UVicRocketry/A3_Modular_Power_Supply/A3_Modular_Power_Supply/3D_models/PSMC_TO-277A__STM.step

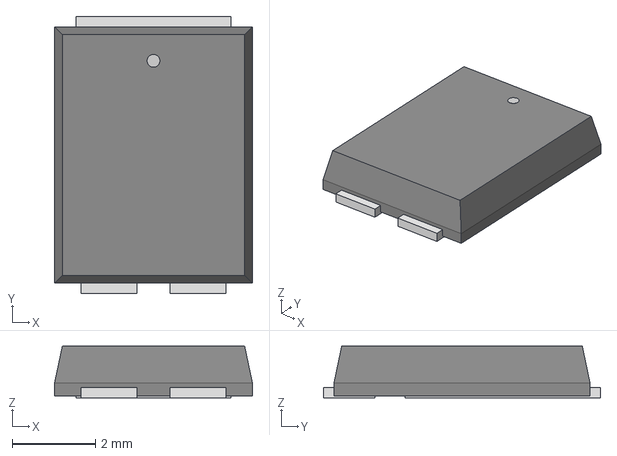
[picture p1: CAD file, 2026-06-01, an earlier design]
A3_Modular_Power_Supply/3D_models/PSMC_TO-277A__STM.step
4.75 x 6.65 x 1.25 mm
