UVicRocketry/A3_Modular_Power_Supply/A3_Modular_Power_Supply/3D_models/FX30B-3P-7.62DSA20.stp

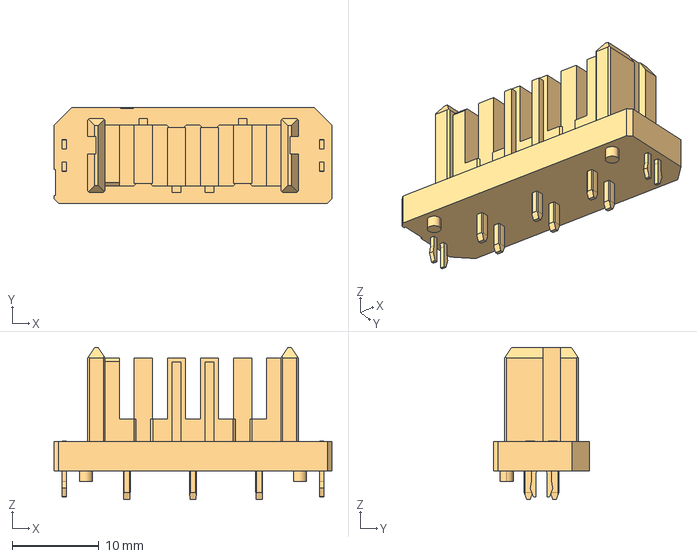
[picture p2: CAD file, 2025-11-07, an earlier design]
A3_Modular_Power_Supply/3D_models/FX30B-3P-7.62DSA20.stp
32.0 x 11.0 x 17.5 mm
