UVicRocketry/A3_Modular_Power_Supply/A3_Modular_Power_Supply/3D_models/FX30B-3S-7.62DSA.stp

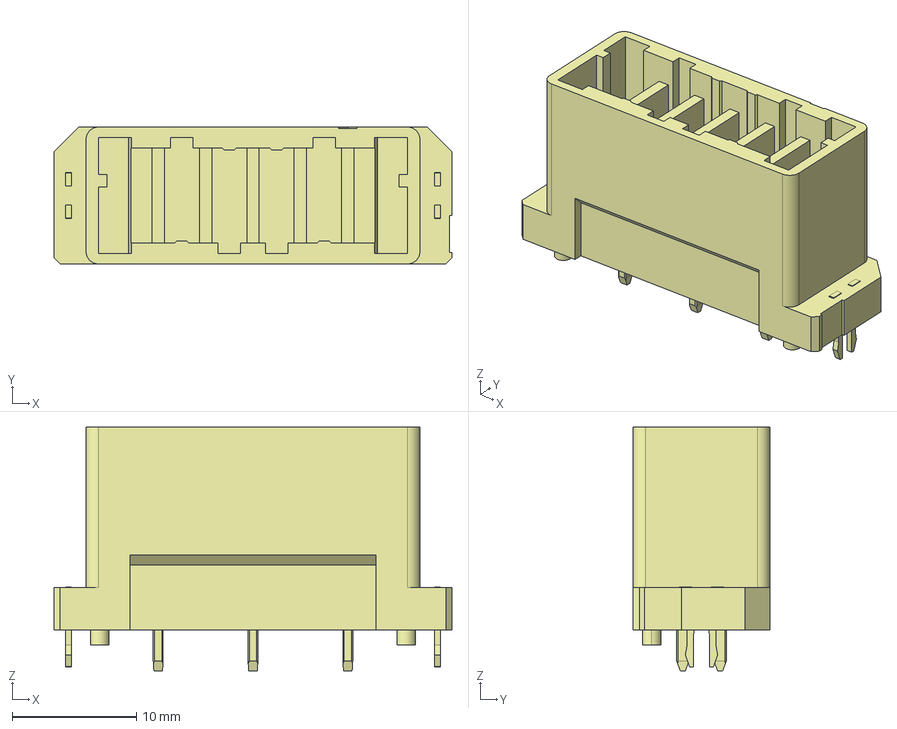
[picture p3: CAD file, 2025-11-07, an earlier design]
A3_Modular_Power_Supply/3D_models/FX30B-3S-7.62DSA.stp
32.0 x 11.0 x 19.6 mm
