UVicRocketry/A3_Modular_Power_Supply/A3_Modular_Power_Supply/3D_models/B2PS-VH.step

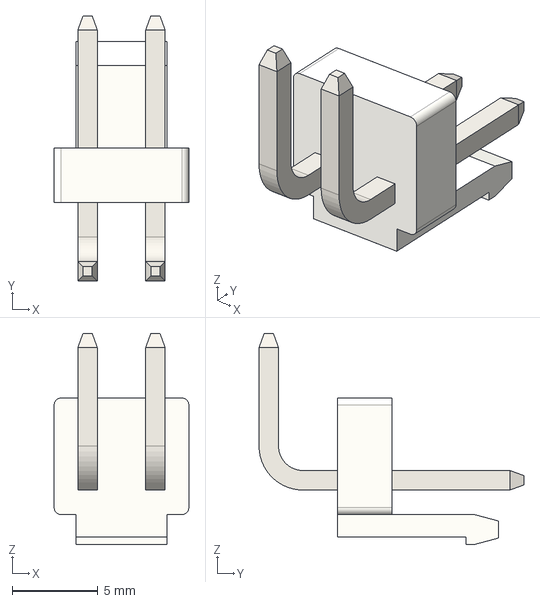
[picture p4: CAD file, 2025-11-07, an earlier design]
A3_Modular_Power_Supply/3D_models/B2PS-VH.step
7.86 x 15.5 x 12.3 mm
