UVicRocketry/A3_Modular_Power_Supply/A3_Modular_Power_Supply/3D_models/MAXIM_90-100154.step

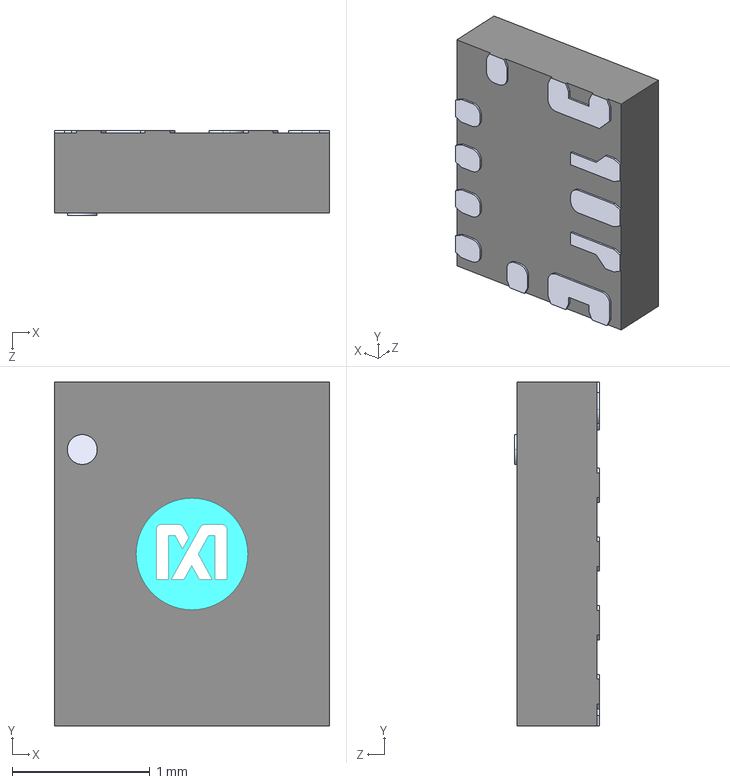
[picture p5: CAD file, 2025-11-07, an earlier design]
A3_Modular_Power_Supply/3D_models/MAXIM_90-100154.step
2.00 x 2.50 x 0.62 mm
