UVicRocketry/A3_Modular_Power_Supply/A3_Modular_Power_Supply/3D_models/SRP1265A series.stp

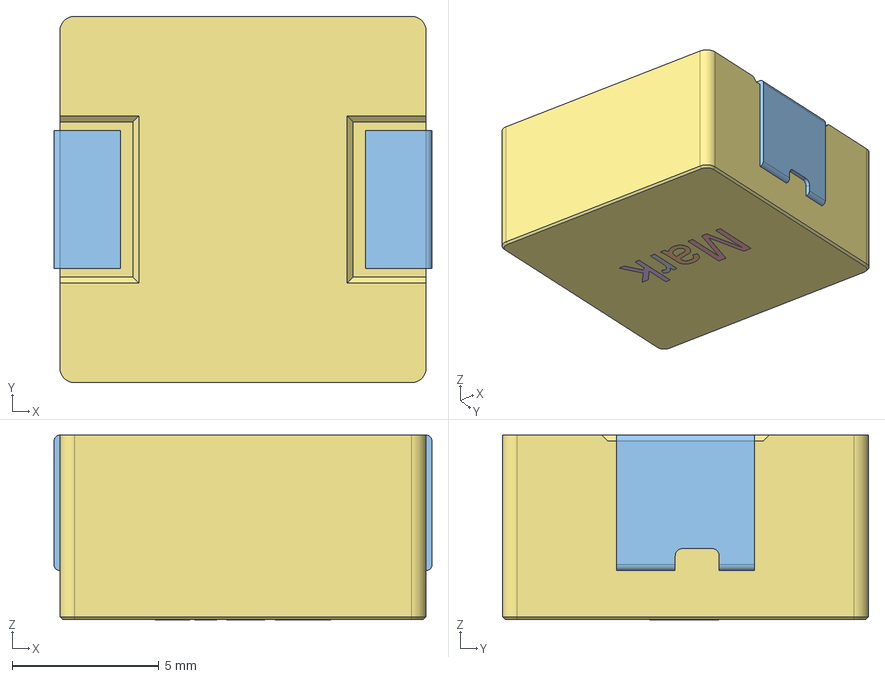
[picture p6: CAD file, 2025-11-07, an earlier design]
A3_Modular_Power_Supply/3D_models/SRP1265A series.stp
12.9 x 12.5 x 6.30 mm
