UVicRocketry/A3_Modular_Power_Supply/A3_Modular_Power_Supply/3D_models/STP_74438366xxx+%28rev1%29.stp

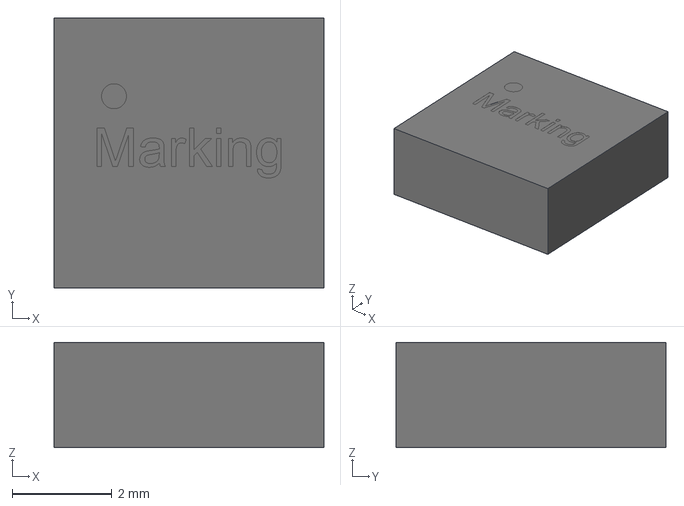
[picture p7: CAD file, 2025-11-07, an earlier design]
A3_Modular_Power_Supply/3D_models/STP_74438366xxx+%28rev1%29.stp
5.40 x 5.40 x 2.10 mm
body_SSMC_5020
land_pattern x 2
