UVicRocketry/A3_Modular_Power_Supply/A3_Modular_Power_Supply/3D_models/74439346xxx (rev1).stp

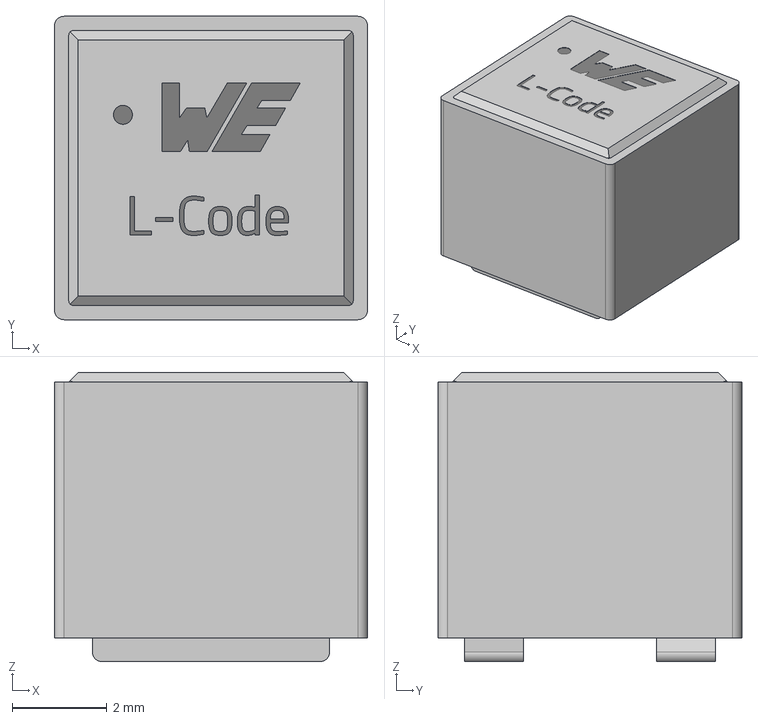
[picture p8: CAD file, 2026-06-01, an earlier design]
A3_Modular_Power_Supply/3D_models/74439346xxx (rev1).stp
6.60 x 6.40 x 6.10 mm
