UVicRocketry/A3_Modular_Power_Supply/A3_Modular_Power_Supply_v2/A3_Modular_Power_Supply_v2.kicad_pcb

## KiCad design A3_Modular_Power_Supply_v2/A3_Modular_Power_Supply_v2.kicad_pcb (2026-06-02)

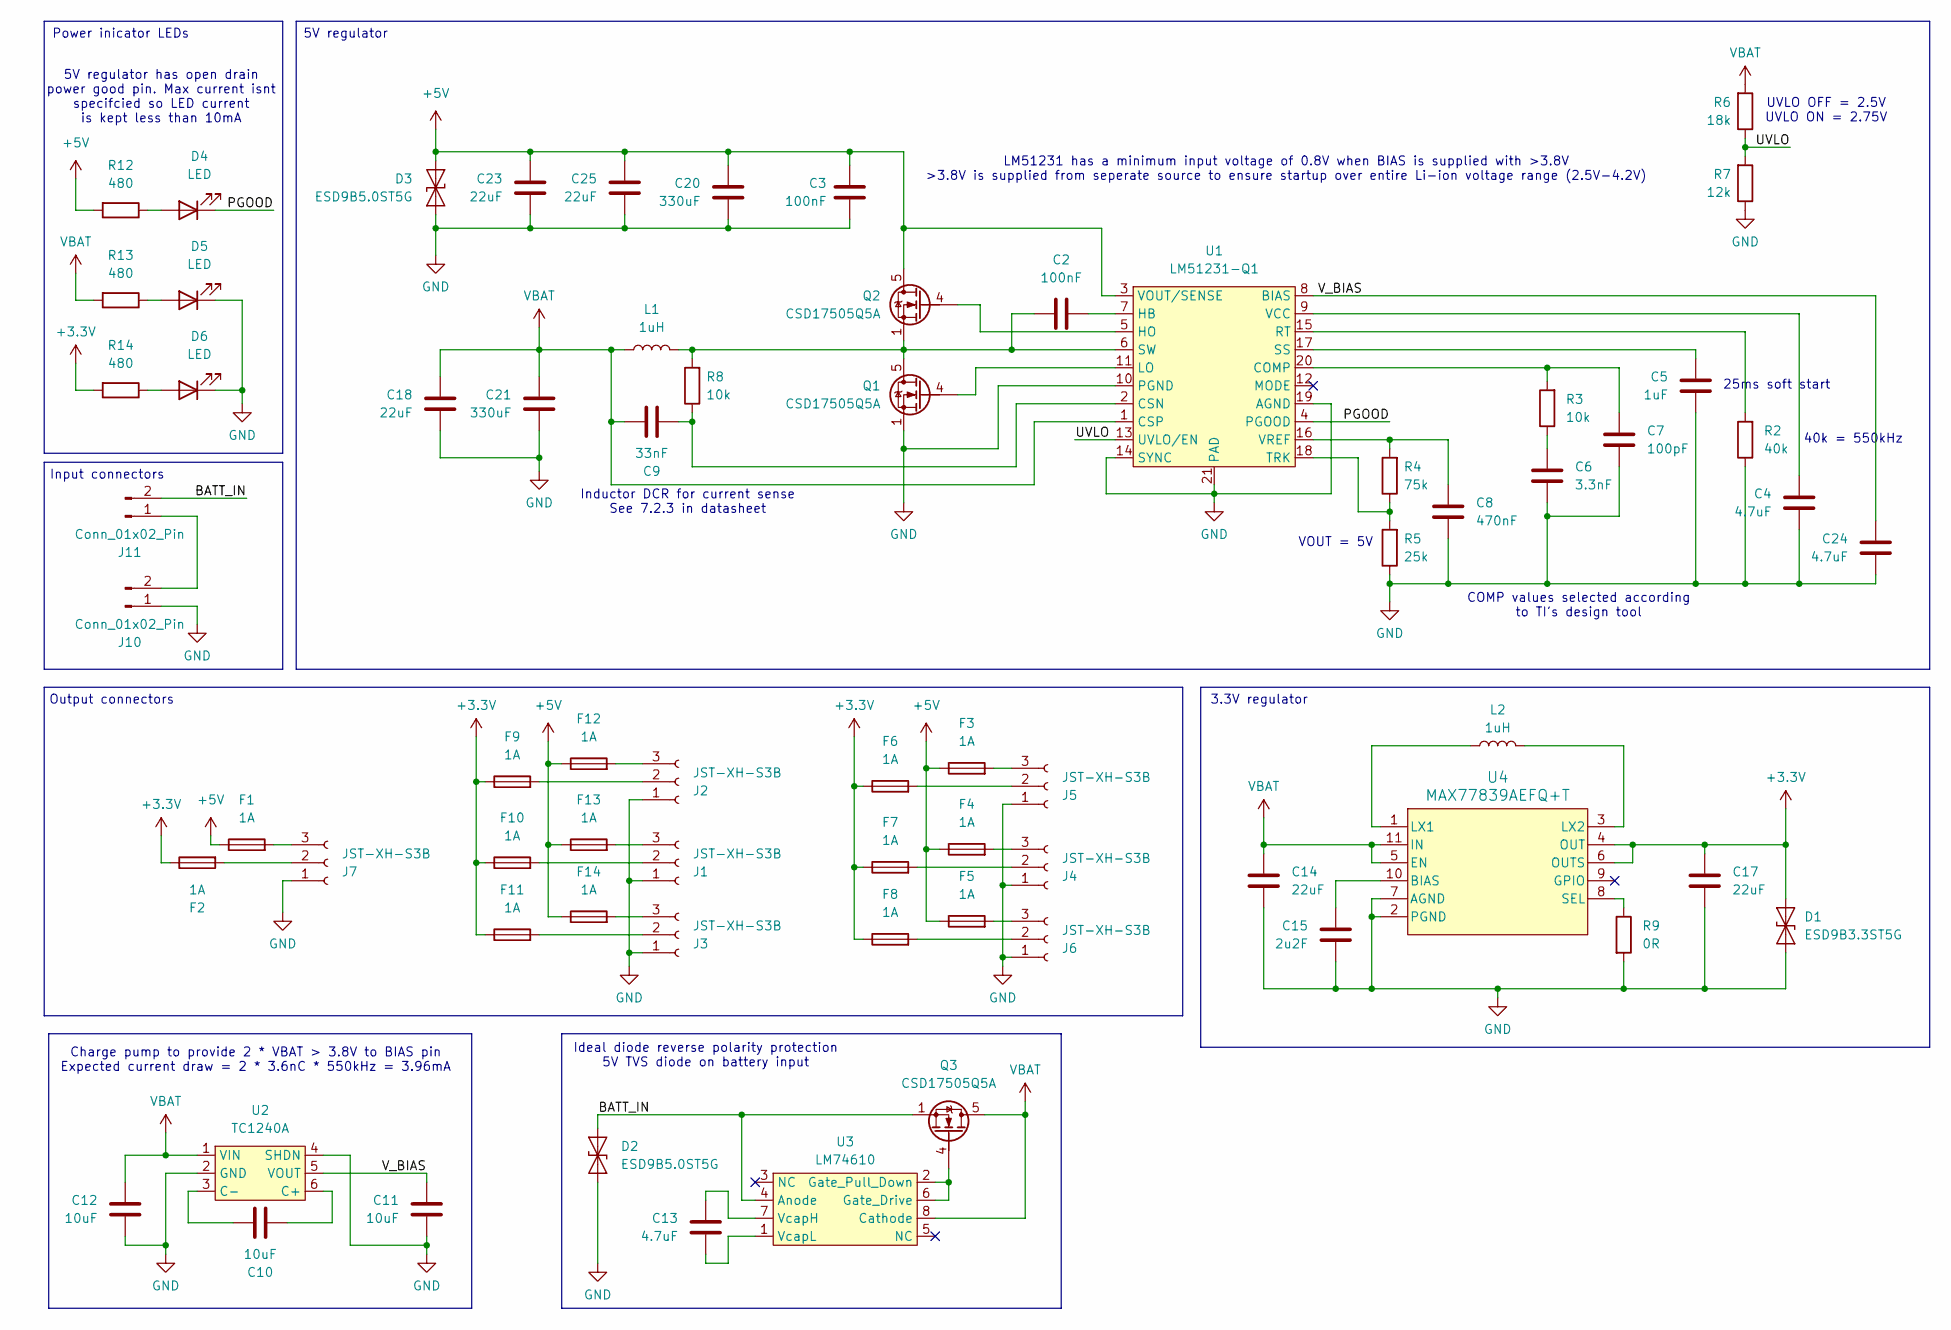
[picture p9: schematic A3_Modular_Power_Supply_v2.kicad_sch]

Parts:
C2, C3: 100nF; C_0402_1005Metric
C4, C13, C24: 4.7uF; C_0603_1608Metric
C5: 1uF; C_0402_1005Metric
C6: 3.3nF; C_0402_1005Metric
C7: 100pF; C_0402_1005Metric
C8: 470nF; C_0402_1005Metric
C9: 33nF; C_0402_1005Metric
C10, C11, C12: 10uF; C_0603_1608Metric
C14, C17, C18, C23, C25: 22uF; C_1210_3225Metric
C15: 2u2F; C_0603_1608Metric
C20, C21: 330uF; CP_Elec_6.3x7.7
D1: ESD9B3.3ST5G; D_SOD-923
D2, D3: ESD9B5.0ST5G; D_SOD-923
D4, D5, D6: LED; LED_0603_1608Metric
F1, F2, F3, F4, F5, F6, F7, F8, F9, F10, F11, F12, F13, F14: 1A; Fuse_0603_1608Metric
J1, J2, J3, J4, J5, J6, J7: JST-XH-S3B; JST_XH_S3B-XH-A_1x03_P2.50mm_Horizontal
J10, J11: Conn_01x02_Pin; JST_VH_B2PS-VH_1x02_P3.96mm_Horizontal
L1: 1uH; SRP1038WA
L2: 1uH; L_Wuerth_MAPI-5020
Q1, Q2, Q3: CSD17505Q5A; TDSON-8-1
R2: 40k; R_0402_1005Metric
R3, R8: 10k; R_0402_1005Metric
R4: 75k; R_0402_1005Metric
R5: 25k; R_0402_1005Metric
R6: 18k; R_0402_1005Metric
R7: 12k; R_0402_1005Metric
R9: 0R; R_0402_1005Metric
R12, R13, R14: 480; R_0402_1005Metric
U1: LM51231-Q1; QFN-20-1EP_3.5x3.5mm_P0.5mm_EP2x2mm
U2: TC1240A; TSOT-23-6
U3: LM74610; VSSOP-8_3x3mm_P0.65mm
U4: MAX77839AEFQ+T; 21-100431_F112A2F&plus_1_MXM

Connections:
+3.3V: C17.1, D1.2 (A2), F2.1, F6.1, F7.1, F8.1, F9.1, F10.1, F11.1, R14.2, U4.4 (OUT), U4.6 (OUTS)
+5V: C3.2, C20.1, C23.1, C25.1, D3.2 (A2), F1.1, F3.1, F4.1, F5.1, F12.1, F13.1, F14.1, Q2.5 (D), R12.2, U1.3 (VOUT/SENSE)
/BATT_IN: D2.2 (A2), J11.2, Q3.1 (S), Q3.2 (S), Q3.3 (S), U3.4 (Anode)
/PGOOD: D4.1 (K), U1.4 (PGOOD)
/UVLO: R6.1, R7.2, U1.13 (UVLO/EN)
/V_BIAS: C11.1, C24.1, U1.8 (BIAS), U2.5 (VOUT)
GND: C3.1, C4.2, C5.2, C6.2, C7.2, C8.2, C11.2, C12.2, C14.2, C15.2, C17.2, C18.2, C20.2, C21.2, C23.2, C24.2, C25.2, D1.1 (A1), D2.1 (A1), D3.1 (A1), D5.1 (K), D6.1 (K), J1.1, J2.1, J3.1, J4.1, J5.1, J6.1, J7.1, J10.1, Q1.1 (S), Q1.2 (S), Q1.3 (S), R2.1, R5.1, R7.1, R9.2, U1.10 (PGND), U1.14 (SYNC), U1.19 (AGND), U1.21 (PAD), U2.2 (GND), U2.4 (SHDN), U4.2 (PGND), U4.7 (AGND)
unnamed: C6.1, R3.1
unnamed: D4.2 (A), R12.1
unnamed: D5.2 (A), R13.1
unnamed: D6.2 (A), R14.1
unnamed: F10.2, J1.2
unnamed: F13.2, J1.3
unnamed: F9.2, J2.2
unnamed: F12.2, J2.3
unnamed: F11.2, J3.2
unnamed: F14.2, J3.3
unnamed: F7.2, J4.2
unnamed: F4.2, J4.3
unnamed: F6.2, J5.2
unnamed: F3.2, J5.3
unnamed: F8.2, J6.2
unnamed: F5.2, J6.3
unnamed: F2.2, J7.2
unnamed: F1.2, J7.3
unnamed: J10.2, J11.1
unnamed: C2.1, L1.2, Q1.5 (D), Q2.1 (S), Q2.2 (S), Q2.3 (S), R8.2, U1.6 (SW)
unnamed: Q1.4 (G), U1.11 (LO)
unnamed: Q2.4 (G), U1.5 (HO)
unnamed: Q3.4 (G), U3.2 (Gate_Pull_Down), U3.6 (Gate_Drive)
unnamed: C7.1, R3.2, U1.20 (COMP)
unnamed: C9.1, R8.1, U1.2 (CSN)
unnamed: C2.2, U1.7 (HB)
unnamed: R2.2, U1.15 (RT)
unnamed: C5.1, U1.17 (SS)
unnamed: R4.1, R5.2, U1.18 (TRK)
unnamed: C4.1, U1.9 (VCC)
unnamed: C8.1, R4.2, U1.16 (VREF)
unnamed: C10.1, U2.6 (C+)
unnamed: C10.2, U2.3 (C-)
unnamed: C13.1, U3.7 (VcapH)
unnamed: C13.2, U3.1 (VcapL)
unnamed: C15.1, U4.10 (BIAS)
unnamed: L2.1, U4.1 (LX1)
unnamed: L2.2, U4.3 (LX2)
unnamed: R9.1, U4.8 (SEL)
VBAT: C9.2, C12.1, C14.1, C18.1, C21.1, L1.1, Q3.5 (D), R6.2, R13.2, U1.1 (CSP), U2.1 (VIN), U3.8 (Cathode), U4.5 (EN), U4.11 (IN)

Notes on the sheet:
5V regulator has open drain power good pin. Max current isnt specifcied so LED current is kept less than 10mA
VOUT = 5V
COMP values selected according to TI's design tool
Inductor DCR for current sense See 7.2.3 in datasheet
Charge pump to provide 2 * VBAT > 3.8V to BIAS pin Expected current draw = 2 * 3.6nC * 550kHz = 3.96mA
Input connectors
Power inicator LEDs
LM51231 has a minimum input voltage of 0.8V when BIAS is supplied with >3.8V >3.8V is supplied from seperate source to ensure startup over entire Li-ion voltage range (2.5V-4.2V)
Ideal diode reverse polarity protection 5V TVS diode on battery input
40k = 550kHz
UVLO OFF = 2.5V UVLO ON = 2.75V
25ms soft start
3.3V regulator
Output connectors
5V regulator

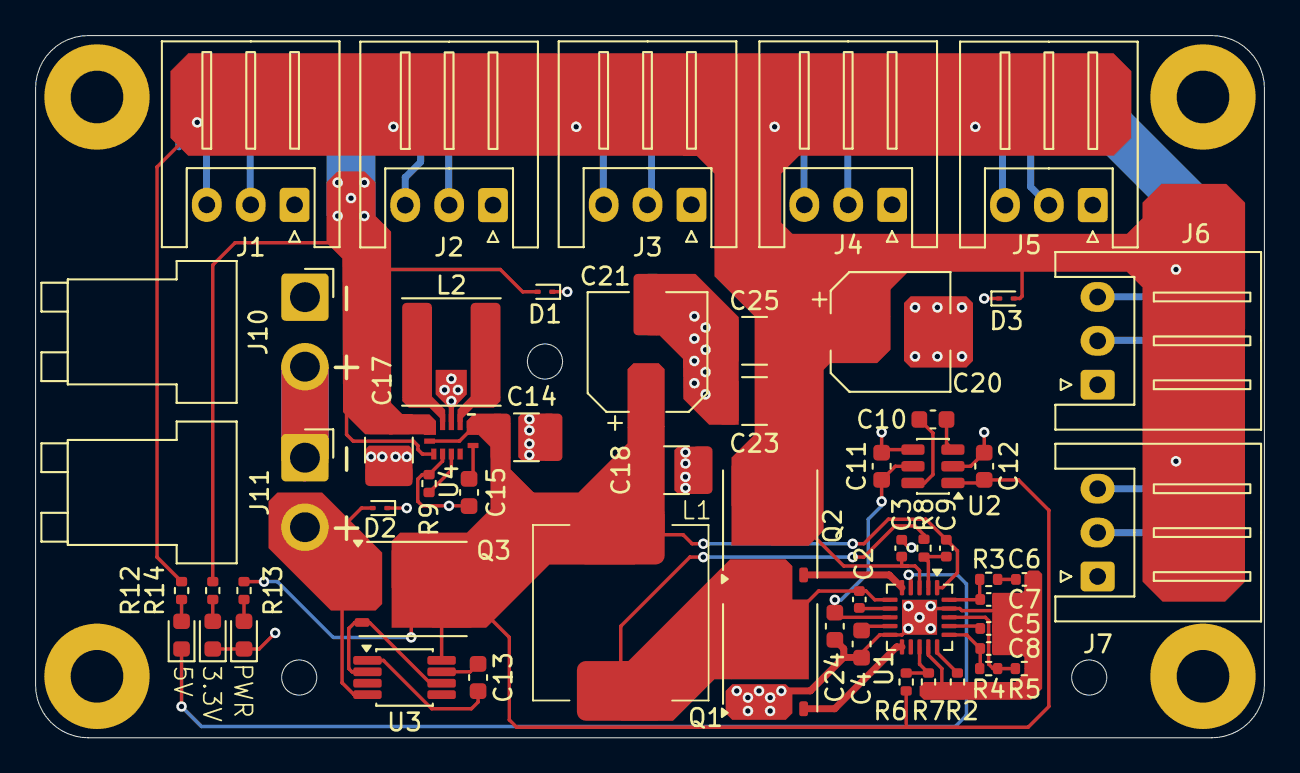
[picture p10: board A3_Modular_Power_Supply_v2.kicad_pcb from above]

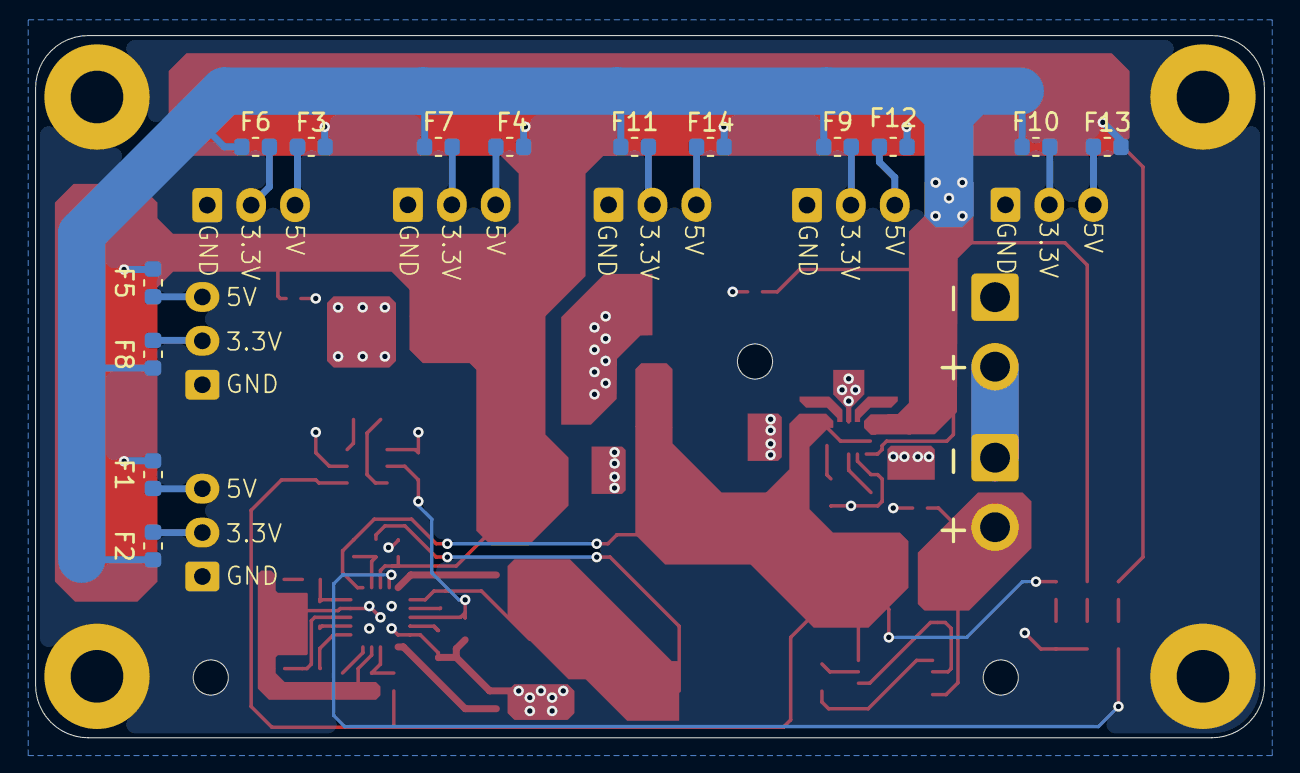
[picture p11: board A3_Modular_Power_Supply_v2.kicad_pcb from below]

Board: 2 copper layers, 70.0 x 40.0 mm, 70 parts (14 on the bottom side), 47 nets.
