UVicRocketry/A3_Modular_Power_Supply/A3_Modular_Power_Supply/A3_Modular_Power_Supply.kicad_pcb

## KiCad design A3_Modular_Power_Supply/A3_Modular_Power_Supply.kicad_pcb (2026-01-04, an earlier design)

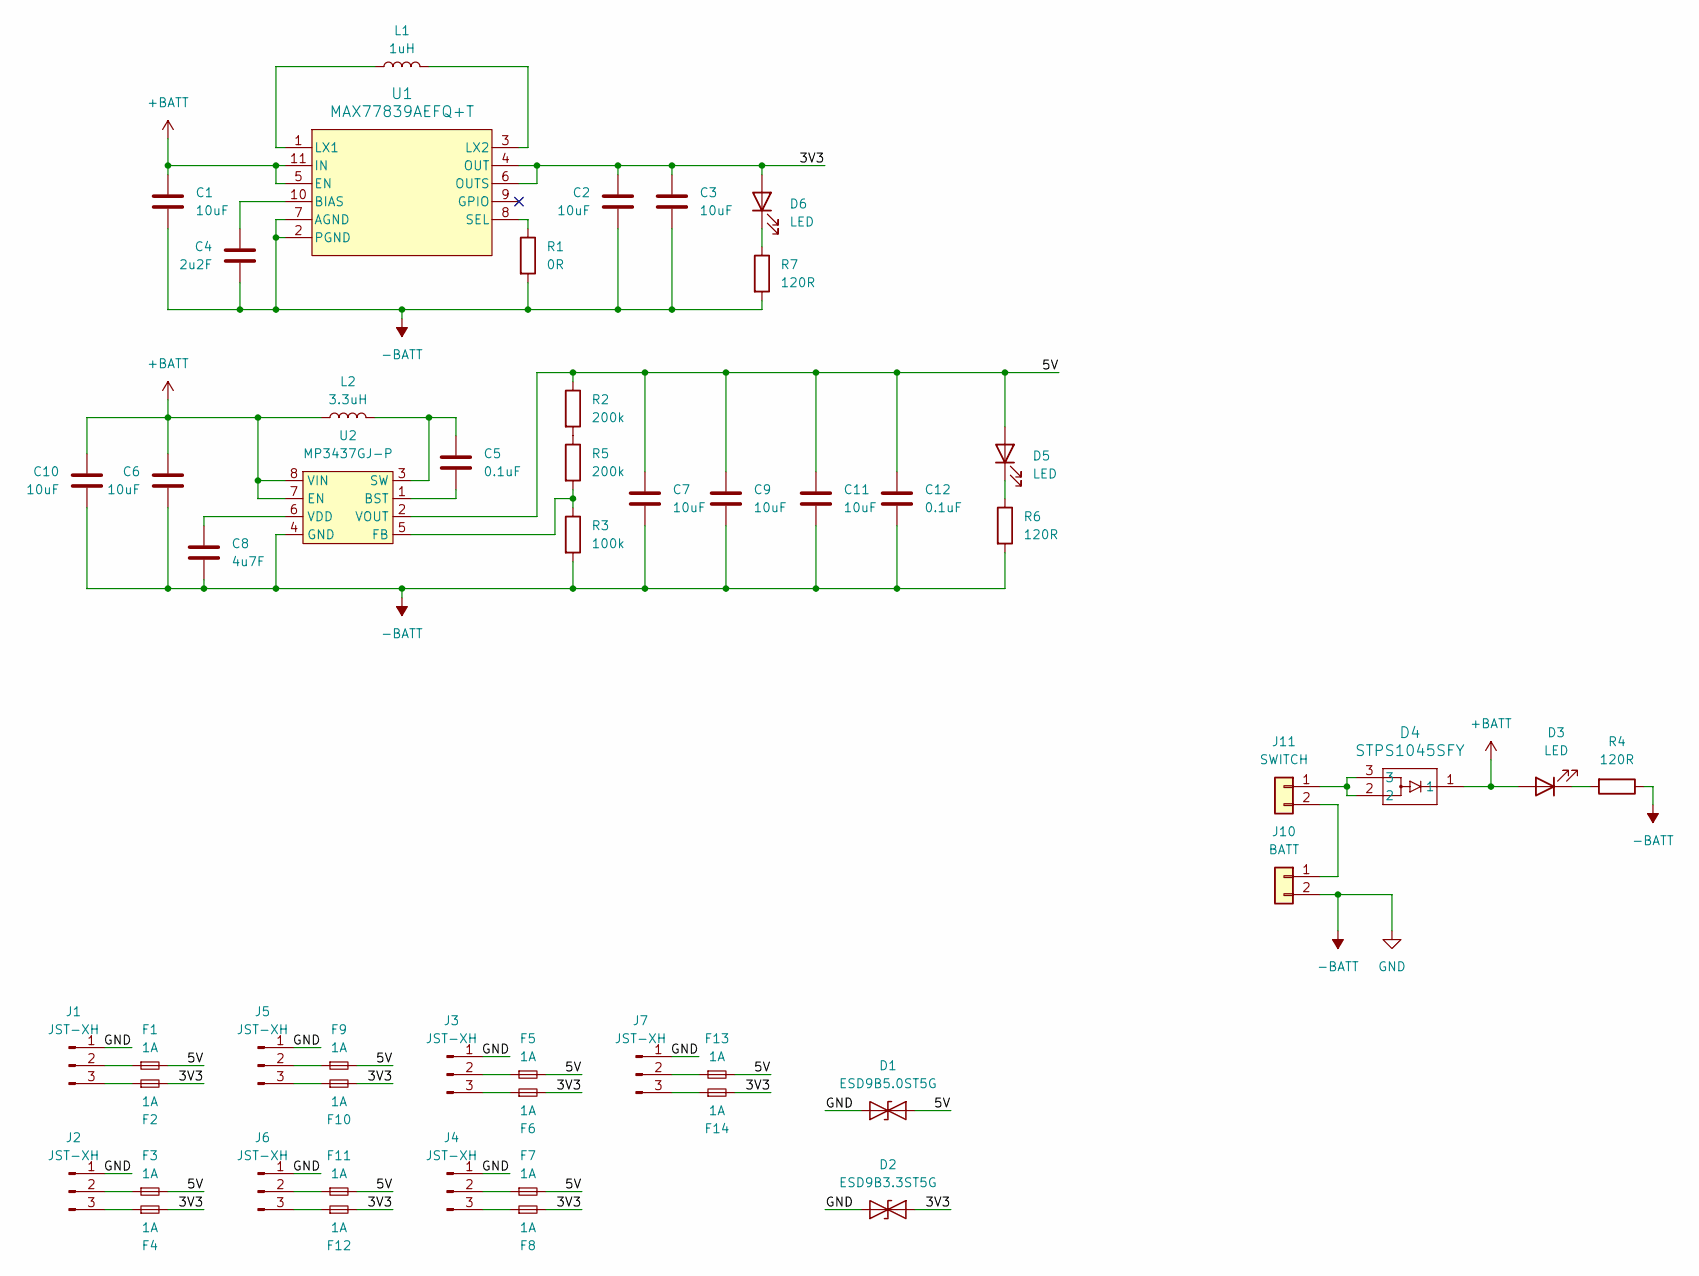
[picture p12: schematic A3_Modular_Power_Supply.kicad_sch]

Parts:
C1, C2, C3, C6, C7, C9, C10, C11: 10uF; C_1206_3216Metric
C4: 2u2F; C_0805_2012Metric
C5, C12: 0.1uF; C_0603_1608Metric
C8: 4u7F; C_0603_1608Metric
D1: ESD9B5.0ST5G; D_SOD-923
D2: ESD9B3.3ST5G; D_SOD-923
D3, D5, D6: LED; LED_0603_1608Metric
D4: STPS1045SFY; PSMCTO-277A_STM
F1, F2, F3, F4, F5, F6, F7, F8, F9, F10, F11, F12, F13, F14: 1A; Fuse_0603_1608Metric
J1, J2, J3, J4, J5, J6, J7: JST-XH; JST_XH_S3B-XH-A_1x03_P2.50mm_Horizontal
J10: BATT; JST_VH_B2PS-VH_1x02_P3.96mm_Horizontal
J11: SWITCH; JST_VH_B2PS-VH_1x02_P3.96mm_Horizontal
L1: 1uH; L_Wuerth_MAPI-5020
L2: 3.3uH; L_Wurth_WE-XHMI-6060P
R1: 0R; R_0603_1608Metric
R2, R5: 200k; R_0603_1608Metric
R3: 100k; R_0603_1608Metric
R4, R6, R7: 120R; R_0603_1608Metric
U1: MAX77839AEFQ+T; 21-100431_F112A2F&plus_1_MXM
U2: MP3437GJ-P

Connections:
+BATT: C1.1, C6.1, C10.1, D3.2 (A), D4.1, L2.1, U1.5 (EN), U1.11 (IN), U2.7 (EN), U2.8 (VIN)
-BATT: C1.2, C2.2, C3.2, C4.2, C6.2, C7.2, C8.2, C9.2, C10.2, C11.2, C12.2, D1.2 (A2), D2.1 (A1), J1.1, J2.1, J3.1, J4.1, J5.1, J6.1, J7.1, J10.2, R1.2, R3.2, R4.1, R6.2, R7.2, U1.2 (PGND), U1.7 (AGND), U2.4 (GND)
/3V3: C2.1, C3.1, D2.2 (A2), D6.2 (A), F2.2, F4.2, F6.2, F8.2, F10.2, F12.2, F14.2, U1.4 (OUT), U1.6 (OUTS)
/5V: C7.1, C9.1, C11.1, C12.1, D1.1 (A1), D5.2 (A), F1.2, F3.2, F5.2, F7.2, F9.2, F11.2, F13.2, R2.1, U2.2 (VOUT)
unnamed: D3.1 (K), R4.2
unnamed: D5.1 (K), R6.1
unnamed: D6.1 (K), R7.1
unnamed: F1.1, J1.2
unnamed: F2.1, J1.3
unnamed: F3.1, J2.2
unnamed: F4.1, J2.3
unnamed: F5.1, J3.2
unnamed: F6.1, J3.3
unnamed: F7.1, J4.2
unnamed: F8.1, J4.3
unnamed: F9.1, J5.2
unnamed: F10.1, J5.3
unnamed: F11.1, J6.2
unnamed: F12.1, J6.3
unnamed: F13.1, J7.2
unnamed: F14.1, J7.3
unnamed: J10.1, J11.2
unnamed: D4.2, D4.3, J11.1
unnamed: R2.2, R5.1
unnamed: C4.1, U1.10 (BIAS)
unnamed: L1.1, U1.1 (LX1)
unnamed: L1.2, U1.3 (LX2)
unnamed: R1.1, U1.8 (SEL)
unnamed: C5.2, U2.1 (BST)
unnamed: R3.1, R5.2, U2.5 (FB)
unnamed: C5.1, L2.2, U2.3 (SW)
unnamed: C8.1, U2.6 (VDD)

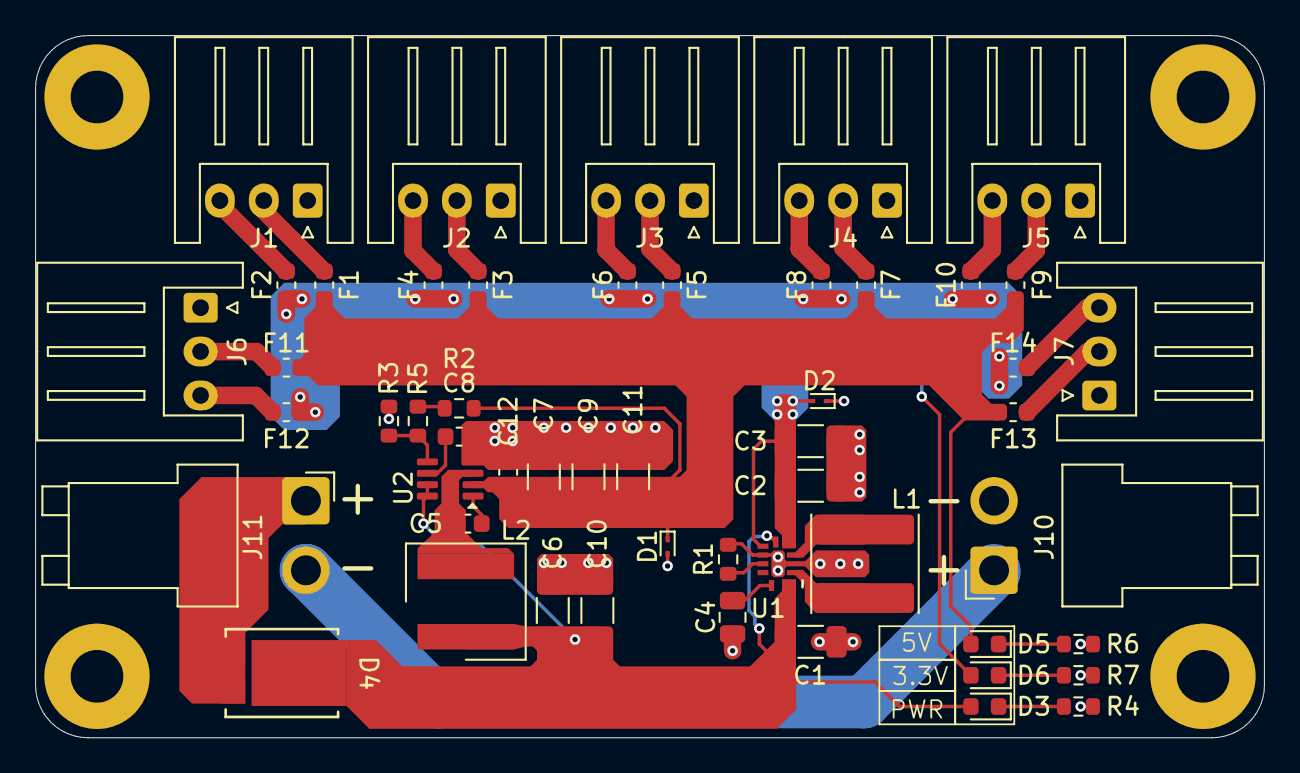
[picture p13: board A3_Modular_Power_Supply.kicad_pcb from above]

Board: 2 copper layers, 70.0 x 40.0 mm, 52 parts (0 on the bottom side), 32 nets.
