UVicRocketry/A3_Modular_Power_Supply/(commit log)

2025-11-14 Removed lock file.
    [A3_Modular_Power_Supply.step]
2025-12-09 Resized board to match flight computer Switched to single PCB
    [A3_Modular_Power_Supply.kicad_pcb, A3_Modular_Power_Supply.kicad_sch, A3_Modular_Power_Supply.step, B2PS-VH.step]
2026-01-04 Added power indication LEDs
    [A3_Modular_Power_Supply.kicad_pcb, A3_Modular_Power_Supply.kicad_sch]
2026-06-01 Version 2 schematic and PCB
    [74439346xxx (rev1).stp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]
2026-06-01 Changed some capacitor package sizes
    [A3_Modular_Power_Supply_v2.kicad_pcb, A3_Modular_Power_Supply_v2.kicad_sch]
2026-06-02 Connector labels, heatsink mounting
    [A3_Modular_Power_Supply_v2.kicad_pcb, cart.csv]
